SaifQasem29/7T-3D-Printed-Diffusion-MRI-Phantoms/CAD_Designs/container cover.stl

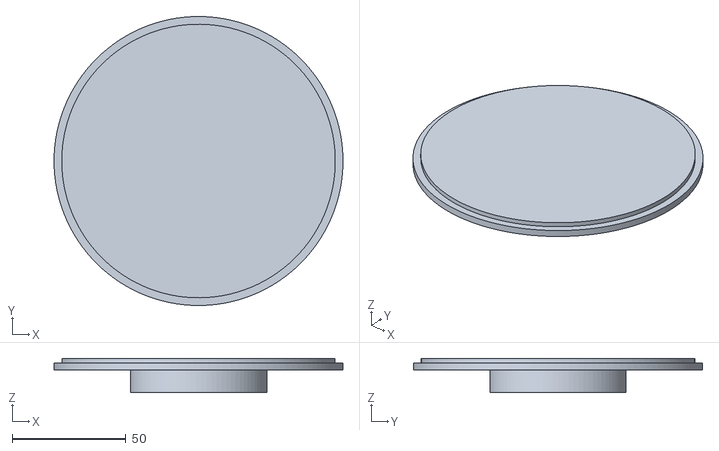
[picture p5: CAD file, 2026-10-25]
CAD_Designs/container cover.stl
127.0 x 127.0 x 15.0
