SaifQasem29/7T-3D-Printed-Diffusion-MRI-Phantoms/PrusaSlicer_Designs/Large Phantom.3mf

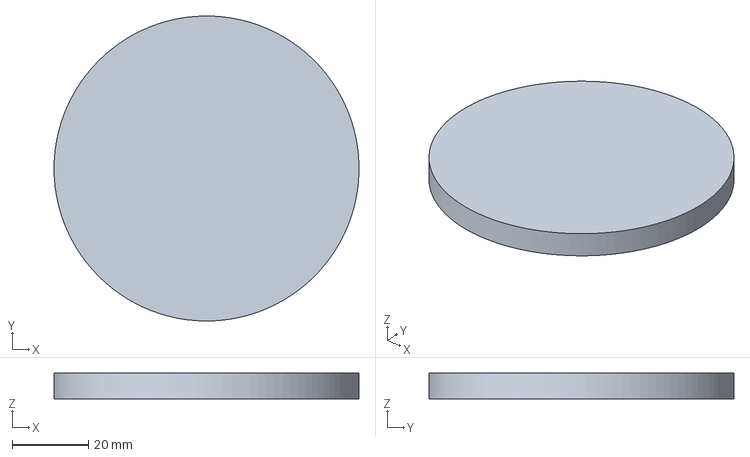
[picture p6: CAD file, 2026-10-25]
PrusaSlicer_Designs/Large Phantom.3mf
80.0 x 80.0 x 6.70 mm
