SaifQasem29/7T-3D-Printed-Diffusion-MRI-Phantoms/PrusaSlicer_Designs/Small Phantom.3mf

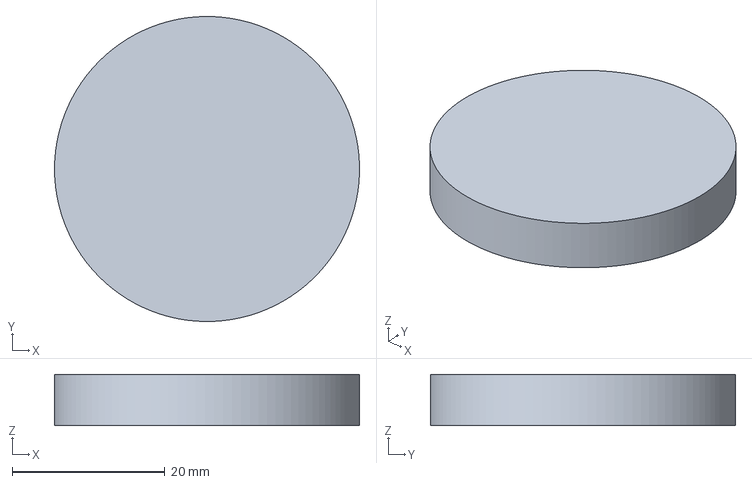
[picture p7: CAD file, 2026-10-25]
PrusaSlicer_Designs/Small Phantom.3mf
40.0 x 40.0 x 6.70 mm
