SaifQasem29/7T-3D-Printed-Diffusion-MRI-Phantoms/CAD_Designs/phantom Base_.stl

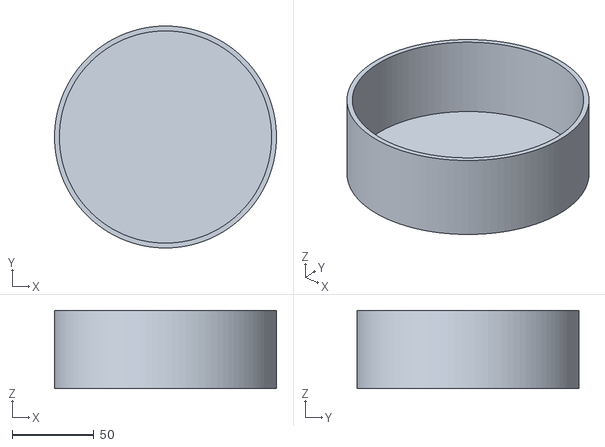
[picture p8: CAD file, 2026-10-25]
CAD_Designs/phantom Base_.stl
136.0 x 136.0 x 48.0
