SaifQasem29/7T-3D-Printed-Diffusion-MRI-Phantoms/PrusaSlicer_Designs/Medium Phantom.3mf

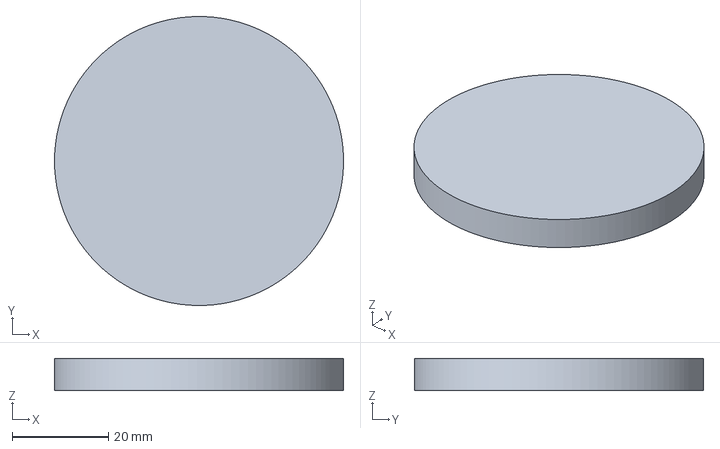
[picture p9: CAD file, 2026-10-25]
PrusaSlicer_Designs/Medium Phantom.3mf
60.0 x 60.0 x 6.70 mm
