SaifQasem29/7T-3D-Printed-Diffusion-MRI-Phantoms/CAD_Designs/Phantom container.stl

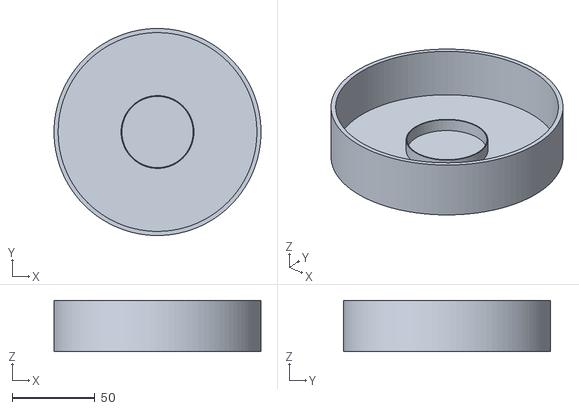
[picture p10: CAD file, 2026-10-25]
CAD_Designs/Phantom container.stl
125.0 x 125.0 x 31.0
