SaifQasem29/7T-3D-Printed-Diffusion-MRI-Phantoms/(list of files, cad)

Other CAD files:
CAD_Designs/Disc_Phantom.stl
