SaifQasem29/7T-3D-Printed-Diffusion-MRI-Phantoms/Printing_Settings/Printing_Parameters.pdf

Printing settings | Prusa XL | Page 1

# Printing Settings

Prusa XL | PrusaSlicer configuration record

Object configuration. The print consists of a main (outer) object and a smaller, centrally positioned copy of the same object used as a PrusaSlicer modifier. The modifier changes the local printing parameters in the central region only: 99% Grid infill and the additional layer/perimeter overrides listed below. The main object uses 100% Aligned Rectilinear infill. All other print, filament, and printer settings below apply to the main object and the modified central region unless superseded by a modifier override.

## 1. Printer and overall setup

Parameter | Value / detail
Printer | Original Prusa XL - 0.4 mm nozzle (Prusa XL)
Filament profiles (two slots) | Generic FLEX (modified); Generic FLEX (modified)
Virtual extruders | Color Mixing
Supports | None
Overall infill displayed | 100%
Brim | Enabled

## 2. Main object - layers and shells

Parameter | Value / detail
Layer height | 0.10 mm
First-layer height | 0.10 mm
Perimeters | 1 (minimum)
Spiral vase | Disabled
Top solid layers | 0
Bottom solid layers | 0
Minimum shell thickness - top | 0.7 mm (locked / inactive)
Minimum shell thickness - bottom | 0.5 mm (locked / inactive)

## 3. Main object - infill and advanced

Parameter | Value / detail
Fill density | 100%
Fill pattern | Aligned Rectilinear
Length of infill anchor | 2 mm
Maximum length of infill anchor | 0 (not anchored)
Top fill pattern | Monotonic Lines (locked / inactive)
Bottom fill pattern | Monotonic (locked / inactive)

Parameter | Value / detail
Solid infill every | 0 layers
Fill angle | 0 degrees
Solid infill threshold area | 0 mm2 (locked / inactive)
Bridging angle | 0 degrees (locked / inactive)
Only retract when crossing perimeters | Disabled
Infill before perimeters | Disabled

## 4. Central modifier - overrides only

Parameter | Value / detail
Geometry / placement | Smaller copy of the main object, centered within the main object
Fill density | 99%
Fill pattern | Grid
Bottom solid layers | 0
External perimeters first | Enabled
Extra perimeters if needed | Disabled
Extra perimeters on overhangs (experimental) | Disabled
Perimeters | 1 (minimum)
Top solid layers | 0

## 5. Speed for print moves

Parameter | Value / detail
Perimeters | 80 mm/s
Small perimeters | 45 mm/s
External perimeters | 45 mm/s
Infill | 110 mm/s
Solid infill | 140 mm/s
Top solid infill | 75 mm/s
Support material | 120 mm/s
Support material interface | 50 mm/s
Bridges | 45 mm/s
Over bridges | 50%
Gap fill | 65 mm/s
Ironing | 15 mm/s

## 6. Extrusion width

Parameter | Value / detail
Default extrusion width | 0.40 mm
First layer | 0.40 mm
Perimeters | 0.40 mm
External perimeters | 0.40 mm
Infill | 0.40 mm
Solid infill | 0.45 mm (locked / inactive)
Top solid infill | 0.42 mm (locked / inactive)
Support material | 0.40 mm (locked / inactive)
Automatic extrusion widths calculation | Disabled

## 7. Filament properties

Parameter | Value / detail
Filament profile | Generic FLEX (modified)
Filament diameter | 1.75 mm
Extrusion multiplier | 1.08
Density | 1.22 g/cm3
Spool weight | 0 g
Idle temperature | 70 degrees C
Nozzle temperature - first layer | 210 degrees C
Nozzle temperature - other layers | 210 degrees C
Bed temperature - first layer | 50 degrees C
Bed temperature - other layers | 50 degrees C
Chamber temperature - nominal | 0 degrees C
Chamber temperature - minimal | 0 degrees C
